gvnn3/sensor-fpga/docs/prompts.md

# Prompt Log — sensor-fpga

All user prompts given to the coding agent, recorded verbatim in reverse
chronological order (newest first). Each entry has the date and time
(HH:MM:SS) when the prompt was received.

---

## 28 Jul 2026 20:45:00

> Add the checklist to the bench sheet and reprint

---

## 28 Jul 2026 20:30:00

> I ordered the parts, add a bring-up checklist to the wiring doc

---

## 28 Jul 2026 20:15:00

> What is a good, small, speaker for the board? / Add the speaker to the
> parts sheet
> *(preceded by: Are these the Adafruit parts or? / Do I need cables for
> the I2C bus?)*

---

## 28 Jul 2026 19:55:00

> I will push, print the wiring diagram for the bench

---

## 28 Jul 2026 01:50:00

> Create a full walk through document explaining how the enire system works
> including the FPGA communication, RTOS, and how the FPGA DFX parts change
> at run time.

---

## 28 Jul 2026 01:40:00

> Create a wiring diagram for all sensors and add it to the docs directory.

---

## 28 Jul 2026 01:25:00

> Merge to main

---

## 28 Jul 2026 01:10:00

> Re-flash QSPI so standalone boot carries the dfx frames

---

## 28 Jul 2026 00:45:00

> Add telemetry information for the DFX switch.  Report on the DFX switched
> to and from the size of each DFX and how long the switch took.  All wokr
> in gnn-dfx-ctx branch.

---

## 28 Jul 2026 00:30:00

> Merge to main

---

## 28 Jul 2026 00:20:00

> I power cycled the board, verify the telemetry still flows

---

## 27 Jul 2026 23:59:00

> keep going until the flash boot passes the listener gate

---

## 27 Jul 2026 22:50:00

> Re-flash QSPI so standalone boot carries the new telemetry

---

## 27 Jul 2026 22:20:00

> Continue
> *(after interrupting a JTAG run/symbol-lookup tool call and switching model
> via /model; no correction given)*

---

## 27 Jul 2026 21:55:00

> keep going until the sensor telemetry shows up in the listener

---

## 27 Jul 2026 21:45:00

> keep going until the switch events show up in nc

---

## 27 Jul 2026 21:35:00

> Also add a telemtry packet whenever a switch is thrown, including the error
> state when multiple switches are thrown.  Indicate the switch number/name in
> the packet

---

## 27 Jul 2026 21:20:00

> Start a new branch gnn-tricorder-telemetry and use ultracode to add
> telemetry for all the sensors planned for the board.  When no data is
> present send a constant value that is outside the range of the sensor
> (-1, etc.)

---

## 27 Jul 2026 21:10:00

> Merge to main

---

## 27 Jul 2026 08:50:00

> There is an ethernet cable plugged in, this can be used for testing, it is
> on a DHCP capable network.  Keep going until the system gets an IP.  Add a
> switch to display the IP address on the 7 SEG display.  If no IP play the
> error sound and show "NO IP"

---

## 27 Jul 2026 08:30:00

> Create a new branch gnn-tricorder-ethernet and integrate an ethernet part
> into the system that can be used to get telemtry and other data our of the
> tricorder.  Use ultracode to create the spec and the code.

---

## 27 Jul 2026 08:10:00

> What kind of connectors do I need to buy to wire up the sensors?
> / Add the connector shopping list to the plan doc and the parts excel sheet

---

## 27 Jul 2026 07:50:00

> Update the plan doc and I will push everything

---

## 27 Jul 2026 07:40:00

> I moved JP1 to QSPI, power cycled, and it works

---

## 27 Jul 2026 07:28:20

> Boot from QSPI so the board runs standalone
> *(with "keep going until the standalone boot gate passes")*

---

## 27 Jul 2026 20:30:00

> Try the promiscuous mode fix and retest ping
> / keep going until it gets an IP

---

## 27 Jul 2026 08:50:00

> There is an ethernet cable plugged in, this can be used for testing, it is
> on a DHCP capable network.  Keep going until the system gets an IP.  Add a
> switch to display the IP address on the 7 SEG display.  If no IP play the
> error sound and show "NO IP"

---

## 27 Jul 2026 08:30:00

> Create a new branch gnn-tricorder-ethernet and integrate an ethernet part
> into the system that can be used to get telemtry and other data our of the
> tricorder.  Use ultracode to create the spec and the code.

---

## 27 Jul 2026 07:05:00

> Update the plan doc with the full session status

---

## 27 Jul 2026 06:56:01

> Add the boot chirp and switch functions to the notebook

---

## 27 Jul 2026 06:40:00

> The alert sound should also play when a DFX signature mismatch occurs

---

## 27 Jul 2026 06:20:00

> The scan sound should also play at boot

---

## 27 Jul 2026 00:10:00

> The DFX personalities should be tied to the functions of the switches.

---

## 26 Jul 2026 23:55:00

> I will push, flip the switches and test the sounds now

---

## 26 Jul 2026 21:25:00

> There is now a sounds directory.  Add the two mp3 files to the repo.  The
> scan sound should be triggered whenever a function is turned on by a
> switch.

---

## 26 Jul 2026 14:30:00

> There are 15 switches on the board and and 8 digit display.  Attach one
> function to each switch and when the function is triggered put a readout
> on the display.  For now there are no real devices, but this is a test
> mode to show that each function can be turned on or off.  Each function
> is exclusive, e.g. if more than one switch is in the ON position anerror
> should be shown on the display.  Design the system and use ultracode to
> implement it.  Create a new document manual.md that is the user manual
> and says what the switches control.

---

## 26 Jul 2026 13:50:00

> Try the ILA on the icap_axis stream
> *(ILA captured constant 0xCCCCCCCC with perfect quad timing — flash
> silent to the XIP core's quad command; XIP standard-mode chain launched)*

---

## 26 Jul 2026 11:30:00

> Try the XIP retry with the fixed STARTUPE2 path
> *(with "keep going until the swap time is measured" continuations)*

---

## 26 Jul 2026 10:20:00

> Try the quad mode SPI speedup

---

## 26 Jul 2026 00:30:00

> Try the QSPI slot table with the compressed partials

---

## 26 Jul 2026 00:05:00

> Try the bitstream compression on the partials

---

## 25 Jul 2026 17:00:00

> Try the AXIS-FIFO writer to get swaps under 20 ms
> *(and "keep going until the swap time is measured")*

---

## 25 Jul 2026 16:30:00

> Try the swap time optimization with taskENTER_CRITICAL

---

## 25 Jul 2026 15:21:12

> I will push, update the notebook with the demo entry first

---

## 25 Jul 2026 10:05:00

> Describe and document how to run the demo.  Commit that as a separate
> demo.md in the docs directory.

---

## 25 Jul 2026 09:50:00

> keep going / Continue
> *(several continuation prompts through the M4-M7 gate runs and the
> integrated demo: "keep going until all M gates pass", "Do not make me
> tell you to keep going, just go. Do not stpo until al M gates pass.",
> "keep going until done", "keep going", "Continue")*

---

## 25 Jul 2026 00:45:00

> Kill the3 sub shells, figure out why they were stuc, and then complete all
> of M4-M7.

---

## 25 Jul 2026 00:12:00

> Update the notebook as each milestone completes

---

## 25 Jul 2026 00:08:00

> When done write up the whole session in the plan doc

---

## 25 Jul 2026 00:05:00

> Do M4 through M7 as the builds finish

---

## 24 Jul 2026 23:52:00

> Do M7

---

## 24 Jul 2026 23:38:00

> Do M6

---

## 24 Jul 2026 23:12:00

> Do M5

---

## 24 Jul 2026 23:05:00

> Do M4

---

## 24 Jul 2026 22:56:30

> Do M3

---

## 24 Jul 2026 22:47:00

> Do M2

---

## 24 Jul 2026 22:42:00

> Do M1

---

## 24 Jul 2026 22:36:30

> Do you need me to run the udev installer yet?

---

## 24 Jul 2026 22:33:00

> Do M0, I'll run the udev installer when you need it

---

## 24 Jul 2026 22:10:00

> Read the docs directory, using ultracode plan the project and describe the
> plan here.  Work in a new branch gnn-a7-tricorder.  The target board is the
> NEXYS A7 and one is connected to this host.

---

## 5 Jul 2026 05:33:22

> This host has 2025.2

---

## 5 Jul 2026 05:14:19

> Continue

---

## 5 Jul 2026 05:08:00

> Write the master XDC for the full sensor complement.

---

## 5 Jul 2026 05:01:07

> Pick the exact A7 board, assume the Arty A7-100T.

---

## 5 Jul 2026 04:58:12

> FreeRTOS is fine fro this application.

---

## 5 Jul 2026 04:30:06

> If I want to run this on the A7 does that have any sort of CPU on which to
> run a typical program?

---

## 5 Jul 2026 04:19:27

> The spreadsheet is updated, re-read it.

---

## 5 Jul 2026 04:11:47

> Can the Tricorder be prototyped on this larger board without access to the
> A7?

---

## 5 Jul 2026 03:53:38

> Try again, I just copied it over.

---

## 5 Jul 2026 03:45:29

> The parts list is in docs now, go find it.

---

## 5 Jul 2026 03:41:44

> *(Pasted transcript of the claude.ai share link from the previous prompt —
> a separate Claude conversation titled roughly "FPGA as a sensor platform".
> Extracted content recorded in notebook entry 4. Transcript excerpts:)*
>
> Treat the FPGA as a sensor platform. What are good examples of data that
> needs low latency processing and to which an FPGA's customizable circuitry
> would be most useful.
>
> [Claude's answer: RF/SDR, network packet streams, machine vision,
> physics instrumentation, control loops]
>
> Are there already open source libraries of such circuits? Prioritize non
> network solutions for now. Physics and vision and real world sensors take
> priority.
>
> [Claude's answer: OHWR, hls4ml, FINN, Vitis Vision, PYNQ, Vitis DSP,
> LiteX/FuseSoC, ZipCPU cores]
>
> Provide a bibliography of papers that are published on these libraries or
> with them. Give links to papers and repositories in the vivl
>
> [Result: 14-entry BibTeX bibliography ("Fpga sensor libs" BIB artifact,
> not included in the paste); also a "Tricorder parts" XLSX with
> Adafruit-prioritized sensor parts list, not included in the paste]

---

## 5 Jul 2026 03:38:27

> Look at this link, can you extract the information from it
> https://claude.ai/share/3ff13c9b-f27d-47c6-ba76-99bd91a29c7b

---

## 5 Jul 2026 00:12:20

> Fix the commits with the rigth email.

---

## 5 Jul 2026 00:08:03

> I will push, you are NEVER to push

---

## 5 Jul 2026 00:07:26

> Add all files and commit

---

## 4 Jul 2026 07:34:03

> Study the open hardware site (ohwr.org) and find software moduels that
> coiuld run on the hardware in this host. The same requirements apply, the
> modules must be able to run in the dynamic region.

---

## 4 Jul 2026 07:26:08

> Look at the https://github.com/xilinx/vitis_libraries repo and explain
> wehther or not those libraries can be used in the dynamic region of the
> FPGA in this system.

---

## 4 Jul 2026 07:20:01

> This is a new repository for experiments having to do with creating dynamic
> sensor FGPA programs (each sensor type can be loaded or removed at runtime
> from the FGPA dynamic region). Create a docs directory with a notebook.md
> file useing the /notebook skill. Entries are kept in reverse chronological
> order and have both a date and a time (hours:min:sec) for when the entry was
> created. Also create a prompts.md in docs and record all prompts.
