gvnn3/sensor-fpga/docs/tricorder_parts.xlsx

Category | Supplier | Part | Qty | Unit Price (USD) | Line Total (USD) | Price Status | Purchase URL | Tricorder Function | Notes
Low-rate / quality | Adafruit | Adafruit BME688 #5046 (gas+temp+RH+pressure, I2C) | 1 | $31.11 |  | VERIFIED DigiKey Jul 2026 | https://www.adafruit.com/product/5046 | Atmospheric/air composition; environment | MOX gas = estimated VOC index, needs baseline cal
Low-rate / quality | Adafruit | Adafruit SCD-41 #5190 (true CO2, NDIR, I2C) | 1 | $49.50 |  | ESTIMATE - not captured this session | https://www.adafruit.com/product/5190 | Atmospheric composition (true CO2) | Only real CO2 ppm in this list
Low-rate / quality | Adafruit | Adafruit VEML7700 #4162 (16-bit lux, I2C) | 1 | $7.24 |  | VERIFIED DigiKey Jul 2026 | https://www.adafruit.com/product/4162 | Light scan (lux) | 0.005-120k lux
Low-rate / quality | Adafruit | Adafruit AS7341 #4698 (11-ch spectral, I2C) | 1 | $15.95 |  | ESTIMATE - not captured this session | https://www.adafruit.com/product/4698 | Composition analysis (crude spectroscopy) | 350-1000 nm
High-rate / DFX | Adafruit | Adafruit PDM MEMS mic #3492 | 6 | $4.95 |  | ESTIMATE - not captured this session | https://www.adafruit.com/product/3492 | Lifeform/motion detection (acoustic localization) | Beamforming array; onboard mic for bring-up first
Low-rate / optional | SparkFun | SparkFun MAX30105 particle/pulse-ox #14045 (I2C) | 1 | $19.50 |  | ESTIMATE - not captured this session | https://www.sparkfun.com/products/14045 | Medical variant (pulse/SpO2) | Adafruit has no stock MAX3010x; SparkFun is best-documented
High-rate / DFX | Generic (eBay/AliExpress) | AD9226 ADC module, 12-bit 65 MS/s parallel, Pmod form | 1 | $25.00 |  | ESTIMATE - generic ~$10-30 | https://fraserinnovations.com/product/fii-bd9226-high-speed-ad-module-12-digital-65mhz-data-sampling-ad9226/ | EM/RF environment scan; sonar RX; transient capture | No Adafruit equivalent. Shared wideband front end
High-rate / DFX | Generic (eBay/AliExpress) | AD9708 DAC module, 8-bit 125 MS/s (often AD9280+AD9708 combo) | 1 | $20.00 |  | ESTIMATE - ~$15-25 | https://www.ebay.com/sch/i.html?_nkw=AD9708+module | Active probing/stimulus (source, sweep, ultrasound TX) | No Adafruit equivalent
High-rate / DFX | Generic (eBay/Amazon) | OV7670 camera module (8-bit DVP, 640x480@30fps) | 1 | $8.00 |  | ESTIMATE - ~$5-12 | https://www.amazon.com/ov7670-camera-module/s?k=ov7670+camera+module | Lifeform/motion detection (vision) | Adafruit discontinued theirs. Get version WITHOUT FIFO
High-rate / DFX | onsemi (DigiKey/Mouser) | SiPM module (onsemi MICROFC-SMA-10035-GEVB eval) | 1 | $150.00 |  | ESTIMATE - unverified; hobby SiPM $30-60 AliExpress | https://www.digikey.com/en/products/detail/onsemi/MICROFC-SMA-10035-GEVB/6220699 | Photon detection / ranging (ToF, photon counting) | No Adafruit equivalent. Needs fast comparator e.g. TLV3501
High-rate / DFX | Generic (eBay/AliExpress) | AD8332 VGA board (ultrasound AFE) | 1 | $30.00 |  | ESTIMATE - ~$25-40 | https://www.ebay.com/sch/i.html?_nkw=AD8332+module | Sonar / structure probing (ultrasound AFE) | No Adafruit equivalent
High-rate / DFX | Generic (Amazon) | Piezo ultrasonic transducers, 40 kHz pair (TX/RX) | 2 | $3.00 |  | ESTIMATE | https://www.amazon.com/s?k=40khz+ultrasonic+transducer+piezo | Sonar / structure probing (pulse-echo TX/RX) | 1 MHz medical piezo is a later upgrade
Wiring / connectors | Generic (Amazon) | Dupont jumper wire kit, M-M + M-F + F-F, 10 cm + 20 cm | 1 | 12 |  | ESTIMATE | https://www.amazon.com/s?k=dupont+jumper+wire+kit | Harness for camera, ADC/DAC, mics, AFE control | Short (10 cm) runs for cam_pclk and adc bus
Wiring / connectors | Generic (Amazon) | 0.1 in male pin headers, 2x6 Pmod plugs (pack) | 1 | 8 |  | ESTIMATE | https://www.amazon.com/s?k=2x6+pin+header+2.54mm | Clean mating into JA/JB/JC/JD/JXADC sockets | Alternative: Digilent 2x6 Pmod cable kits
Wiring / connectors | Adafruit | STEMMA QT / Qwiic JST-SH 4-pin cable, 100 mm (#4210) | 4 | 0.95 |  | ESTIMATE | https://www.adafruit.com/product/4210 | I2C daisy chain across the 5 sensor breakouts | Breakouts carry onboard pull-ups; no resistors needed
Wiring / connectors | Adafruit | JST-SH 4-pin to male dupont adapter cable (#4209) | 1 | 0.95 |  | ESTIMATE | https://www.adafruit.com/product/4209 | Qwiic chain entry into Pmod JA1/JA2 | One per harness
Wiring / connectors | Generic (Amazon) | SMA male-male cable, RG316, ~30 cm | 1 | 8 |  | ESTIMATE | https://www.amazon.com/s?k=sma+male+to+male+rg316 | SiPM eval board to comparator input | SiPM board is SMA-only
Wiring / connectors | Generic (Amazon) | SMA female pigtail / edge adapter to 0.1 in | 2 | 4 |  | ESTIMATE | https://www.amazon.com/s?k=sma+female+pigtail+breadboard | SiPM comparator + AD8332 analog entries | One for TLV3501 input, one spare for AFE
Wiring / connectors | Generic (Amazon) | Solderless breadboard 830pt + wire kit | 1 | 10 |  | ESTIMATE | https://www.amazon.com/s?k=830+breadboard+kit | TLV3501 comparator, mic-array fan-out, AFE area | -
Wiring / connectors | Generic (Amazon) | Screw terminal block, 2-pin 0.1 in (pack) | 1 | 5 |  | ESTIMATE | https://www.amazon.com/s?k=screw+terminal+2.54mm | Piezo TX/RX bare-wire attachment | Twisted pair to the transducers
Wiring / connectors | Adafruit | Adafruit STEMMA Speaker #3885 (enclosed, class-D amp, JST-PH) | 1 | 5.95 |  | ESTIMATE | https://www.adafruit.com/product/3885 | Audible scan/alert sounds at the bench | Power from Pmod 3V3+GND; signal from the AUD 3.5 mm jack
Wiring / connectors | Generic (Amazon) | 3.5 mm mono plug to bare-wire pigtail | 1 | 4 |  | ESTIMATE | https://www.amazon.com/s?k=3.5mm+mono+plug+pigtail | Tap the Nexys AUD jack into the STEMMA speaker input | Mono jack: tip = signal, sleeve = GND
 |  | TOTAL
Adafruit parts shaded and sorted first (preferred supplier). Non-Adafruit parts have no Adafruit equivalent. Prices 2026-07-05: 'VERIFIED' seen in a distributor listing this session; 'ESTIMATE' from prior knowledge/typical range - confirm before ordering. Unit prices (blue) editable; totals are formulas.
