gvnn3/sensor-fpga/hw/constraints/switches-7seg.xdc

## ---------------------------------------------------------------------------
## Tricorder test-mode switch/7-seg constraints — Digilent Nexys A7-100T
## (xc7a100tcsg324-1)
##
## sw[15:0]  all 16 slide switches -> axi_gpio_3 (16-bit input, 0x40030000).
##           SW0..SW14 select the 15 test-mode functions; SW15 is reserved
##           (constrained here, ignored by software).
## seg[7:0]  cathode segments, ACTIVE-LOW at the pins; bit order fixed:
##           bit0=CA bit1=CB bit2=CC bit3=CD bit4=CE bit5=CF bit6=CG bit7=DP.
##           The top-level scanner RTL inverts from the active-high 64-bit
##           display register ({axi_gpio_4 ch2, ch1}) before driving these.
## an[7:0]   digit anodes, ACTIVE-LOW; an[0] = rightmost digit (AN0),
##           an[7] = leftmost (AN7) — matches display-register byte order.
##
## Pin LOCs and IOSTANDARDs copied verbatim from the Digilent
## Nexys-A7-100T master XDC. SW8 (T8) and SW9 (U8) sit in bank 34 and are
## LVCMOS18 per that file — preserved exactly; all other pins LVCMOS33.
## ---------------------------------------------------------------------------

## ---------------------------------------------------------------------------
## Switches (SW0..SW14 = function select, SW15 reserved)
## ---------------------------------------------------------------------------
set_property -dict { PACKAGE_PIN J15   IOSTANDARD LVCMOS33 } [get_ports { sw[0] }];  #IO_L24N_T3_RS0_15 Sch=sw[0]
set_property -dict { PACKAGE_PIN L16   IOSTANDARD LVCMOS33 } [get_ports { sw[1] }];  #IO_L3N_T0_DQS_EMCCLK_14 Sch=sw[1]
set_property -dict { PACKAGE_PIN M13   IOSTANDARD LVCMOS33 } [get_ports { sw[2] }];  #IO_L6N_T0_D08_VREF_14 Sch=sw[2]
set_property -dict { PACKAGE_PIN R15   IOSTANDARD LVCMOS33 } [get_ports { sw[3] }];  #IO_L13N_T2_MRCC_14 Sch=sw[3]
set_property -dict { PACKAGE_PIN R17   IOSTANDARD LVCMOS33 } [get_ports { sw[4] }];  #IO_L12N_T1_MRCC_14 Sch=sw[4]
set_property -dict { PACKAGE_PIN T18   IOSTANDARD LVCMOS33 } [get_ports { sw[5] }];  #IO_L7N_T1_D10_14 Sch=sw[5]
set_property -dict { PACKAGE_PIN U18   IOSTANDARD LVCMOS33 } [get_ports { sw[6] }];  #IO_L17N_T2_A13_D29_14 Sch=sw[6]
set_property -dict { PACKAGE_PIN R13   IOSTANDARD LVCMOS33 } [get_ports { sw[7] }];  #IO_L5N_T0_D07_14 Sch=sw[7]
set_property -dict { PACKAGE_PIN T8    IOSTANDARD LVCMOS18 } [get_ports { sw[8] }];  #IO_L24N_T3_34 Sch=sw[8] (bank 34, LVCMOS18 per Digilent master)
set_property -dict { PACKAGE_PIN U8    IOSTANDARD LVCMOS18 } [get_ports { sw[9] }];  #IO_25_34 Sch=sw[9] (bank 34, LVCMOS18 per Digilent master)
set_property -dict { PACKAGE_PIN R16   IOSTANDARD LVCMOS33 } [get_ports { sw[10] }]; #IO_L15P_T2_DQS_RDWR_B_14 Sch=sw[10]
set_property -dict { PACKAGE_PIN T13   IOSTANDARD LVCMOS33 } [get_ports { sw[11] }]; #IO_L23P_T3_A03_D19_14 Sch=sw[11]
set_property -dict { PACKAGE_PIN H6    IOSTANDARD LVCMOS33 } [get_ports { sw[12] }]; #IO_L24P_T3_35 Sch=sw[12]
set_property -dict { PACKAGE_PIN U12   IOSTANDARD LVCMOS33 } [get_ports { sw[13] }]; #IO_L20P_T3_A08_D24_14 Sch=sw[13]
set_property -dict { PACKAGE_PIN U11   IOSTANDARD LVCMOS33 } [get_ports { sw[14] }]; #IO_L19N_T3_A09_D25_VREF_14 Sch=sw[14]
set_property -dict { PACKAGE_PIN V10   IOSTANDARD LVCMOS33 } [get_ports { sw[15] }]; #IO_L21P_T3_DQS_14 Sch=sw[15] (reserved, ignored by software)

## ---------------------------------------------------------------------------
## 7-segment display — cathodes (active-low), bit0=CA .. bit6=CG, bit7=DP
## ---------------------------------------------------------------------------
set_property -dict { PACKAGE_PIN T10   IOSTANDARD LVCMOS33 } [get_ports { seg[0] }]; #IO_L24N_T3_A00_D16_14 Sch=ca
set_property -dict { PACKAGE_PIN R10   IOSTANDARD LVCMOS33 } [get_ports { seg[1] }]; #IO_25_14 Sch=cb
set_property -dict { PACKAGE_PIN K16   IOSTANDARD LVCMOS33 } [get_ports { seg[2] }]; #IO_25_15 Sch=cc
set_property -dict { PACKAGE_PIN K13   IOSTANDARD LVCMOS33 } [get_ports { seg[3] }]; #IO_L17P_T2_A26_15 Sch=cd
set_property -dict { PACKAGE_PIN P15   IOSTANDARD LVCMOS33 } [get_ports { seg[4] }]; #IO_L13P_T2_MRCC_14 Sch=ce
set_property -dict { PACKAGE_PIN T11   IOSTANDARD LVCMOS33 } [get_ports { seg[5] }]; #IO_L19P_T3_A10_D26_14 Sch=cf
set_property -dict { PACKAGE_PIN L18   IOSTANDARD LVCMOS33 } [get_ports { seg[6] }]; #IO_L4P_T0_D04_14 Sch=cg
set_property -dict { PACKAGE_PIN H15   IOSTANDARD LVCMOS33 } [get_ports { seg[7] }]; #IO_L19N_T3_A21_VREF_15 Sch=dp

## ---------------------------------------------------------------------------
## 7-segment display — digit anodes (active-low), an[0]=rightmost .. an[7]=leftmost
## ---------------------------------------------------------------------------
set_property -dict { PACKAGE_PIN J17   IOSTANDARD LVCMOS33 } [get_ports { an[0] }]; #IO_L23P_T3_FOE_B_15 Sch=an[0]
set_property -dict { PACKAGE_PIN J18   IOSTANDARD LVCMOS33 } [get_ports { an[1] }]; #IO_L23N_T3_FWE_B_15 Sch=an[1]
set_property -dict { PACKAGE_PIN T9    IOSTANDARD LVCMOS33 } [get_ports { an[2] }]; #IO_L24P_T3_A01_D17_14 Sch=an[2]
set_property -dict { PACKAGE_PIN J14   IOSTANDARD LVCMOS33 } [get_ports { an[3] }]; #IO_L19P_T3_A22_15 Sch=an[3]
set_property -dict { PACKAGE_PIN P14   IOSTANDARD LVCMOS33 } [get_ports { an[4] }]; #IO_L8N_T1_D12_14 Sch=an[4]
set_property -dict { PACKAGE_PIN T14   IOSTANDARD LVCMOS33 } [get_ports { an[5] }]; #IO_L14P_T2_SRCC_14 Sch=an[5]
set_property -dict { PACKAGE_PIN K2    IOSTANDARD LVCMOS33 } [get_ports { an[6] }]; #IO_L23P_T3_35 Sch=an[6]
set_property -dict { PACKAGE_PIN U13   IOSTANDARD LVCMOS33 } [get_ports { an[7] }]; #IO_L23N_T3_A02_D18_14 Sch=an[7]

# Mono audio out (PWM through the on-board 4th-order LPF) + amp enable
set_property -dict { PACKAGE_PIN A11 IOSTANDARD LVCMOS33 } [get_ports aud_pwm]; #IO_L4N_T0_15 Sch=aud_pwm
set_property -dict { PACKAGE_PIN D12 IOSTANDARD LVCMOS33 } [get_ports aud_sd];  #IO_L6P_T0_15 Sch=aud_sd
