gvnn3/sensor-fpga/sw/tricorder-rtos/src/ui.h

/*
 * Tricorder test-mode UI: switch-selected 7-seg readouts.
 *
 * Other tasks publish live values through ui_live; ui_task samples the
 * switches every 100 ms and drives the 8-digit display registers.
 */

#ifndef UI_H
#define UI_H

/* Live values filled in by main.c's tasks (single-writer per field;
 * plain volatile is enough for these monotonic/latest-value readouts). */
struct ui_live {
    volatile int req_rm;        /* -1 none, 0 PDM, 1 sonar, 2 B, 3 A */
    volatile unsigned int ip;   /* DHCP lease, host byte order; 0 = none */
    /* Switch-change events: ui_task increments evt_seq after filling the
     * record; net_task emits one UDP event frame per new seq (it owns the
     * MAC). evt_sw: 0..15 selected, -1 none/idle, -2 multi-switch error. */
    volatile unsigned int evt_seq;
    volatile int evt_sw;
    volatile unsigned int evt_mask;   /* raw switch bits at the event */
    volatile int cur_rm;        /* loaded personality, -1 while swapping */
    /* DFX swap events: dfx_task fills the record then increments dfx_seq;
     * net_task emits one type=dfx UDP frame per new seq (same single-
     * writer pattern as evt_*). Ids use the req_rm encoding above. */
    volatile unsigned int dfx_seq;
    volatile int dfx_from;            /* RM loaded before the swap        */
    volatile int dfx_to;              /* RM requested                     */
    volatile unsigned int dfx_from_len;  /* partial sizes, bytes; 0 = n/a */
    volatile unsigned int dfx_to_len;
    volatile unsigned int dfx_us;     /* decouple->sig ICAP stream time   */
    volatile unsigned int dfx_flash_us; /* QSPI slot read time; 0 = DDR src */
    volatile int dfx_ok;              /* 1 signature matched, 0 mismatch  */
    volatile int      temp_centi;   /* ADT7420, centi-C (S4) */
    volatile unsigned swaps;        /* completed DFX swaps (S7) */
    volatile unsigned last_swap_us; /* last swap duration, us; 0 = none (S13) */
    volatile int      i2c_devices;  /* external bus scan result (S5) */
    volatile int      pcm;          /* last PDM PCM sample (S10, future) */
    volatile unsigned energy;       /* last PDM energy window (S11, future) */
    volatile unsigned peak;         /* last sonar peak (S12, future) */
};

extern struct ui_live ui_live;

void ui_task(void *arg);

/* Tag for switch id 0..15 ("PdM", "Snr", ...); "none"/"error" for -1/-2 */
const char *ui_fn_name(int id);
const char *ui_rm_name(int id);   /* req_rm encoding; -1 -> "NONE" */

#endif /* UI_H */
