gvnn3/sensor-fpga/(commit log)

2026-07-05 A list of parts for a tricorder projects with the Xilinx A7
    [tricorder_parts.xlsx]
2026-07-05 Record shared-conversation extraction: FPGA as a sensor platform
    Notebook entry 4 captures the pasted claude.ai share-link transcript:
    low-latency sensor workload classes, open-source library survey (OHWR,
    hls4ml, FINN, Vitis Vision/DSP, LiteX, ZipCPU), and pointers to the
    bibliography and tricorder-parts artifacts not included in the paste.
2026-07-05 Updated with the columns fixed.
    [tricorder_parts.xlsx]
2026-07-05 Notebook entry 5: tricorder parts list analysis (Artix-7 target)
    Parse tricorder_parts.xlsx and record the 13-part, $392 BOM; map
    low-rate I2C sensors to the static region and the seven high-rate
    front ends to per-sensor DFX modules.
2026-07-05 Notebook entry 8: board decision Arty A7-100T with pin/resource budget
2026-07-05 Add master XDC for full tricorder sensor complement on Arty A7-100T
    75 conflict-free pin assignments, LOCs verified against Digilent's
    Arty-A7-100-Master.xdc. OV7670 on high-speed JB/JC with PCLK clock
    constraints, AD9226 on the resistor-free ChipKit header, PDM array on
    JA, AD9708 on JD, SiPM/AFE/piezo on ChipKit inner pins. Notebook
    entry 9 records the allocation.
2026-07-05 Revise entry 10: Vivado 2023.1 (Artix-7 + free DFX) validates XDC clean
    /usr/local/cad has 2020.2/2023.1/2025.2; 2025.2 lacks Artix-7 device
    support, so 2023.1 is the working toolchain. Validation passes there:
    75/75 ports, 0 errors, 0 critical warnings.
2026-07-25 Plan Nexys A7-100T retarget: pin map, architecture, roadmap
    Board changes from Arty A7-100T to Nexys A7-100T (same XC7A100T-CSG324
    part, one attached to this host). Multi-agent planning run reconciled
    into docs/plan.md: 40/40 header-pin allocation keeping all sensing
    modalities wired (AD9708 DAC time-shares the AD9226 pins via IOBUFs),
    cam_pclk on the board's only P-side clock-capable header pin (JB10/H16),
    AD9226 derated to <=40 MS/s behind 200-ohm series resistors, MicroBlaze-V
    + FreeRTOS static region with DDR2 MIG and RMII shim on Vivado 2025.2,
    2-clock-region DFX partition, M0-M7 roadmap. Notebook entry 11 records
    the planning experiment; prompt logged.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
2026-07-25 M0 bring-up: blinky builds, programs, and runs on the Nexys A7-100T
    Vivado 2025.2 non-project flow: 0 warnings, WNS +7.2 ns, 3.83 MB
    bitstream programmed over JTAG (DONE=1, XADC die temp 48.6 C). No udev
    installer needed - plugdev group covers the FT2232. DFX confirmed
    license-free in 2025.2 via HD.RECONFIGURABLE probe, unblocking M5.
    Adds reusable program.tcl JTAG helper and notebook entry 12.
    Claude-Session: https://claude.ai/code/session_01JFCZE5zCJbM3sB1FtBfeBa
2026-07-25 M1: Nexys A7 master XDC validates clean alongside Arty control
    New tricorder_top_nexys stub (58 ports) and
    tricorder-nexys-a7-100t.xdc implementing the plan section-2 allocation:
    40/40 header pins, ADC/DAC bus shared through IOBUFs, cam_pclk on
    H16 (the board's only P-side MRCC header pin), all LOCs verified
    against the current Digilent master XDC. validate_xdc.tcl rewritten as
    a parameterized CI gate (-tclargs <board>) with nonzero exit on
    unplaced ports, DRC errors, or critical warnings. Both boards PASS
    under Vivado 2025.2: nexys-a7 58/58, arty-a7 75/75, 0 DRC, 0 critical
    warnings. Notebook entry 13.
    Claude-Session: https://claude.ai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
2026-07-25 M2: MicroBlaze static region prints hello over UART
    Tcl-scripted block design (classic MicroBlaze, 32 KB LMB, UARTlite,
    GPIO LEDs) builds board-file-free in Vivado 2025.2 with WNS +2.7 ns.
    Bare-metal 250-byte ELF (own crt, polled UARTlite at pinned address
    0x40600000) loaded via xsdb prints "hello tricorder" on /dev/ttyUSB1.
    CPU decision ratified: classic MicroBlaze. 2025.2 ships the
    MicroBlaze-V IP but no FreeRTOS port for it (BSPs cover ARM +
    MicroBlazeV9 only), so the FreeRTOS requirement forces classic.
    Notebook entry 14.
    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
2026-07-25 M3: DDR2 calibrates and passes full 128 MiB memtest, 3/3 cycles
    MIG 7-series configured from Digilent's board-file mig.prj (committed;
    BD variant swaps SystemClock to No Buffer so clk_wiz feeds 100 MHz
    sys + 200 MHz ref). Build WNS +1.3 ns; automation added the AXI clock
    converter and 81.25 MHz ui_clk reset domain. Bare-metal memtest gates
    on init_calib_complete via GPIO ch2, then walks all of 0x80000000 +
    128 MiB: addr-in-addr, inverted, walking ones - 0 errors across three
    configuration cycles. Notebook entry 15.
    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
2026-07-25 M4: FreeRTOS boots on MicroBlaze; I2C proven via on-board ADT7420
    BD grows M4 peripherals (axi_intc wired to the CPU interrupt, axi_timer
    tick, axi_iic x2) plus the M5 DFX statics (HWICAP with eos_in tied
    high, DFX decoupler in MODE slave, RM AXI-Lite port at 0x44A10000,
    decouple GPIO). Two hardware lessons fixed en route: cache "None"
    leaves MicroBlaze with no instruction path to DDR (PC froze at
    0x80000000 - now 16KB I/D caches with MIG behind the cached port), and
    the FreeRTOS linker script must keep .vectors.* in LMB while the rest
    moves to DDR2.
    Vitis 2025.2 SDT flow scripted in sw/scripts/build_rtos.py. On the
    board: scheduler ticks steadily for 60 s, heartbeat + sensor tasks
    interlea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
2026-07-25 M5-M7: runtime DFX swaps at 390 ms; PDM and sonar RMs live on hardware
    M5: four-personality DFX flow (pr_verify clean), 1.07 MB partials,
    MicroBlaze-driven runtime swaps with signatures verified and the static
    region uninterrupted. AXI HWICAP v3.0 proved non-functional (write FSM
    wedges on the first chunk regardless of eos_in, clocking, JTAG state,
    or data); replaced with a raw ICAPE2 writer on the second ICAP site -
    GPIO-paced, UG470 bit-reversal in RTL - measuring 390,191 us per swap,
    inside the plan's PIO estimate. eos_in tie-high, explicit pblock site
    ranges (CLOCKREGION+SNAPPING snapped to empty), black-box stub, and
    bin_file partial format were all necessary fixes discovered en route.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
2026-07-25 Integrated demo: FreeRTOS rotates all four DFX personalities live
    New dfx_task in the FreeRTOS app swaps PDM -> SONAR -> B -> A every 8 s
    through the raw ICAPE2 writer, verifies signatures, and reads each
    personality's data registers - while the ADT7420 sampling and heartbeat
    tasks run uninterrupted through every swap. One-command demo via
    hw/scripts/run_rtos_dfx.xsdb. Swap under the RTOS measures 16.2 s
    (scheduler overhead on the GPIO pacing loop; bare-metal is 390 ms) -
    queued for a critical-section or FIFO-writer fix.
    Also: hw/Makefile CI targets (validate / ooc-rm / static / dfx / rtos)
    with hw/scripts/ooc_rm.tcl enforcing per-RM utilization budgets, and a
    cached full-range memtest re-r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
2026-07-25 Cut RTOS swap time 15.9 s -> 1.65 s; culprit was -O0, not preemption
    taskENTER_CRITICAL around the ICAP stream changed nothing - but the
    byte-identical per-swap timings it produced proved preemption was
    innocent. The Vitis app template builds at -O0; forcing O2 on dfx_task
    (plus inline bswap) gives 1.65 s per swap, 9.6x faster. Timing now uses
    the axi_timer's second counter since ticks freeze inside the critical
    section. Residual 4x vs bare-metal is cold-cache DDR reads + shared
    instruction fetch; next step change is the planned AXIS-FIFO writer.
    Notebook entry 22; demo.md figures updated.
    Claude-Session: https://claude.ai/code/session_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
2026-07-25 DMA-fed ICAPE2: swaps hit wire speed at 2.7 ms
    axi_dma (simple MM2S, 26-bit length) streams the staged partial from
    DDR2 straight into an AXIS sink on the ICAPE2 - one config word per
    100 MHz cycle, CSIB gated by tvalid, full 32-bit bit-reversal done in
    wiring (byteswap composed with UG470 per-byte reverse), so raw
    -bin_file bytes need no software preprocessing. Both loaders now
    program three DMA registers and poll Idle; the RTOS path drops its
    critical section entirely.
    Measured: bare-metal 2679 us per 1.07 MB swap - exactly the
    267,763-word/100 MHz theoretical, i.e. the configuration port's
    physical limit; FreeRTOS 2688 us with ticks and sensor tasks running
    through the swap. Swap-time hi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
2026-07-26 Compressed partials: sub-millisecond swaps
    BITSTREAM.GENERAL.COMPRESS on all DFX bitstreams: partials shrink
    2.5-3.4x (312-422 KB, content-dependent), the full image halves to
    1.9 MB, and pr_verify stays clean. MFWR frames stream through the
    DMA->ICAPE2 path at full rate: bare-metal swaps 781-1055 us (still
    exactly words/100MHz), FreeRTOS 903-1067 us with all signatures,
    PDM audio, and sonar bursts verified. Swap history closes at
    16.2 s -> 1.65 s -> 2.7 ms -> ~0.9 ms: a personality change now costs
    less than one scheduler tick. Notebook entry 24; demo.md updated.
    Claude-Session: https://claude.ai/code/session_01JFCZE5zCJbM3sB1FtBfeBa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
2026-07-26 QSPI slot table: personalities load from flash, no JTAG staging
    Partials live in the 16 MiB S25FL128S in 1 MiB slots; one script
    (build_flash.tcl) emits both the MCS image and the compiled-in slot
    manifest slots.h, and program_flash.tcl burns it over JTAG. Hardware:
    axi_quad_spi in command mode with per-signal BD ports - the top
    wrapper owns the IOBUFs and a STARTUPE2 driving the dedicated CCLK.
    Per swap the RTOS fast-reads the slot into a DDR2 bounce buffer and
    reuses the DMA->ICAPE2 wire-speed path, with signature-checked
    fallback to DDR staging.
    Final gate: JEDEC 01 20 18 at boot, all four personalities load from
    FLASH with signatures verified (PDM live audio, sonar bursts intact).
    ICAP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
2026-07-26 Quad SPI lands functionally; proves the flash reader is CPU-bound
    Core to quad mode at SCK/2 (50 MHz, 4 lanes ~ 25 MB/s wire), dq2/dq3
    wired through BD/top/XDC, S25FL128S QE bit set once at boot (WREN+WRR,
    verified by RDCR; persists). Quad 0x6B framing measured on hardware:
    RX overhead is 8 bytes (cmd + 3 addr + 8 dummy cycles at quad = 4
    bytes), not the naive 5 - the +3 data shift was caught by the per-RM
    signature check. All four personalities load from FLASH with correct
    data.
    Timing verdict: 4.9-6.1 s per slot, essentially unchanged - a 32x
    wire speedup moved totals <10%, so the polled driver (per-byte
    DTR/DRR AXI accesses) was always the bottleneck, wire never was.
    Identified root caus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
2026-07-26 XIP retry: 21 MB/s transfers proven, data framing unresolved; reverted
    On the fixed STARTUPE2/CCLK path, XIP-mode DMA transfers now complete:
    20.9 ms for a 444 KB slot (21.2 MB/s) - confirming entry 26's dead-CCLK
    root-cause theory for the original XIP failure. But the ICAP never
    synced in either flash byte order, implying an intra-word framing shift
    inside the XIP core's quad command sequence (Spansion 0xEB mode-bit /
    dummy-cycle handling) that software cannot observe or fix - XIPSR
    reports no errors and only the per-RM signature check catches it.
    Reverted to the entry-26 quad-command configuration (re-gated: all
    four personalities from FLASH, 4.9-6.1 s reads, sigs OK). The 20.9 ms
    figure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
2026-07-27 Test-mode UI: 15 switch functions, 7-seg readouts, tricorder sounds
    SW0-SW14 select 15 mutually exclusive test-mode functions; the 8-digit
    7-seg display shows each function's readout (live values for
    temperature, I2C device count, DFX swap count/time, uptime;
    placeholder On markers elsewhere), an idle trICordr banner, and
    Err SEL when more than one switch is up. The TOS tricorder scan sound
    plays whenever a function is switched on and the alert sound on
    entering the error state, from a 48 KiB BRAM audio ROM (sounds/*.mp3
    committed; tools/mp3_to_mem.py regenerates via miniaudio) through a
    sigma-delta PWM into the on-board audio filter.
    Hardware: axi_gpio_3/4/5 (switches, 64-bit segment regis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
2026-07-27 Switches drive the DFX personalities
    SW0-SW3 now load their personality for real: the ui task publishes the
    request (HELA maps to hello-A, HELB to hello-B), and dfx_task -
    rotation removed - swaps reactively, marking cur_rm during the load.
    The S0-S3 readouts track the state (---- while swapping, run when
    live), PCM/energy go live off the RM registers when PDM is loaded,
    sonar peak when sonar is loaded, and the sonar personality auto-fires
    a ranging burst every second while selected. The scan sound is now
    literally the personality load sound. Manual and demo updated.
    On-board gate: boot with no auto-rotation, idle banner byte-exact,
    sensors streaming; switch-flip loads verified by hand at t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
2026-07-27 Play the scan sound at boot
    main() pulses the scan trigger right after the boot banner; ui_task
    seeds its toggle state from the register so the first switch flip
    still edges. Register gate: AUDIO reads 1 after boot with the banner
    intact. Manual notes the power-on chirp.
    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
2026-07-27 Notebook entry 30: switch-driven personalities, boot chirp, mismatch alert
    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
2026-07-27 Plan doc: continuation status through entry 30
    Appends the post-milestone status to plan section 5: the swap-time
    arc (16.2 s to 0.8 ms), flash-resident personalities with the
    CPU-bound verdict, the closed XIP investigation with its ILA method,
    the test-mode UI with switch-driven personality loads and sounds, and
    the standing next steps.
    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
2026-07-27 Standalone QSPI boot: bitstream + bootloader + app, no host required
    The flash now carries the complete instrument: full_a.bit at 0x0
    (write_cfgmem -loadbit, SPI_BUSWIDTH 4, CONFIGRATE 33) with a 1.4 KB
    bootloader baked into the LMB BRAM via updatemem, the app as a
    scatter-load image at 0xD00000 (tools/mkbootimg.py packs the ELF's
    PT_LOAD segments), and the personality slots. The bootloader waits for
    DDR2 calibration, quad-reads the image, loads each segment - the
    app's vectors overwrite its own by design - and jumps.
    Two MCS images because write_cfgmem flags are global and config data
    vs slot data need opposite bit-order treatment; program_flash.tcl
    burns both ranges. Gate passed twice con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
2026-07-27 Entry 31 revision: power-on standalone boot confirmed on hardware
    George moved JP1 to QSPI and power cycled - the board boots the full
    tricorder from flash with no host attached.
    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
2026-07-27 Connector shopping list: plan section 6 + parts sheet rows
    Eight "Wiring / connectors" rows appended to tricorder_parts.xlsx
    (~$56 estimated: dupont kits, 2x6 Pmod plugs, Qwiic daisy cables +
    dupont adapter for the I2C chain, SMA cable + pigtails for SiPM/AFE,
    breadboard, screw terminals) with line-total formulas and the grand
    TOTAL extended to the new range. Plan gains a matching section with
    the wiring rationale: 10 cm runs for cam_pclk and the ADC bus, no
    harness pull-ups needed (breakouts carry them), SCD-41 current spikes
    on their own Pmod rail.
    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
2026-07-28 Ethernet: telemetry streams to the network; DHCP lease still pending
    Ultracode workflow produced docs/ethernet-spec.md (854 lines, all
    interfaces frozen), hw/rtl/rmii_shim.v, hw/constraints/ethernet.xdc and
    sw/tricorder-rtos/src/net.{c,h} (EmacLite driver, ARP, ICMP, UDP
    telemetry, no lwIP); its verifier caught the two integration gaps and a
    missing create_generated_clock. Integrated: axi_ethernetlite at
    0x40E00000, PHY-reset GPIO, 50 MHz clk_wiz output, shim + REFCLK ODDR in
    the top wrapper, net_task in main.c, plus a DHCP client and SW15 (IP on
    the 7-seg, "nO IP" + alert sound when leaseless).
    Hardware result: telemetry captured on this host with nc -ulp 5001
    (seq/uptime/temp_cc/rm...), P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
2026-07-28 DHCP lease acquired: 192.168.1.126, ping and telemetry both live
    Two stacked bugs, each masking the other. First, the bitstream still
    carried TX_LOOPBACK=1 from an earlier bisect, so the board was deaf to
    the wire during every receive measurement in entry 32 - removing it
    made real LAN traffic appear at once and disproved the MAC-filter
    theory. Second, and the actual defect: the RMII TX flops launch on the
    clk50 rising edge while the ODDR forwarded REFCLK rising at the same
    instant, so the PHY sampled TXD exactly as it changed. Zero setup
    margin, working or failing on placement luck - it worked on one build
    and died on the next. Forwarding REFCLK inverted (D1=0/D2=1) centres
    the PHY's sampli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
2026-07-28 Switch-event telemetry frames, verified on the wire
    Every switch transition now emits a UDP event frame within ~10 ms:
    type=event, evt sequence, sw number (-1 idle, -2 multi-switch error),
    the function name from the UI table, state, raw switch mask, uptime.
    ui_task publishes the record (it already owns transition detection for
    the sounds); net_task emits (single-writer rule for the MAC). Periodic
    frames gain type=telemetry so one listener distinguishes both.
    Wire-verified from the board's DHCP address via JTAG-injected records:
    active and error events captured interleaved with telemetry. Physical
    flips write the identical record. Noted: nc -ulp is single-datagram on
    this host - use a loop o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
2026-07-28 Full 75-key sensor telemetry live on the wire; two AXI IIC driver bugs fixed
    New sensors.c discovery/poll layer and net_telemetry.c emitter (frozen
    75-key schema, docs/telemetry-spec.md) replace the old 10-key frame and
    the unbounded I2C walk in main.c. All nine ultracode verifier findings
    (F1-F9) addressed: single emitter in net_telemetry.c, tri-state link
    detection, no fabricated in-range values from identity-only devices,
    below-floor readings emit error sentinels instead of clamping into
    range, RM-internal counters capability-gated, bounded I2C spins, NAK TX
    FIFO flush, doc example frames match as-built truth.
    Hardware bring-up found two PG090 driver bugs masking the whole bus:
    - IISR is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
2026-07-28 QSPI re-flash carries new telemetry; flash boot passes the listener gate
    Full DFX rebuild was required: the flashed full_a.bit predated the
    REFCLK ODDR inversion fix, so the standalone app booted but its
    Ethernet TX was dead on the wire (PHY loopback 0/60; DHCP discover
    unanswered) - a clean A/B confirmation of entry 33's phase diagnosis,
    since only the bitstream differed between the failing and passing runs.
    The rebuild surfaced and removed the inert ethernet ILA block in
    build_dfx.tcl (create_debug_core "vacant channels" bug, never worked);
    its removal shrank every RM partial ~15%, which changed the generated
    slots.h and forced the documented rebuild order: DFX build -> app
    rebuild (slot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
2026-07-28 Cold power-cycle confirmed: standalone flash boot streams telemetry
    User power-cycled the board (JP1 on QSPI): FPGA configured from flash,
    bootloader pulled the app from flash, DHCP lease reacquired, and the
    listener captured 16 full 75-key frames in 20 s with live ADT7420
    readings (temp_cc=3306). QE bit survived the power cycle as expected
    (non-volatile). Entry 35 observation added; open item removed.
    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
2026-07-28 DFX swap telemetry: from/to personality, partial sizes, swap time
    Each attempted personality swap now emits an aperiodic type=dfx UDP
    frame: RM id and name switched from and to, byte size of each partial
    bitstream (from the source actually streamed), decouple-to-signature
    swap time in microseconds, signature verdict, lifetime swap counter.
    dfx_task publishes the record and bumps ui_live.dfx_seq; net_task
    emits - same single-writer pattern as the switch events. Failed swaps
    are reported with sig=mismatch rather than suppressed.
    The common UDP broadcast tail moved from net_send_event into
    udp_bcast_finish(), shared by event and dfx frames. Also fixed two F5
    stragglers the earlier pass missed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
2026-07-28 QSPI re-flash: standalone boot emits dfx swap frames
    Bootimg repack only - bitstream and partials unchanged, slots.h stable.
    QE restored after programming (entry 35 procedure). Flash-booted board
    reacquired its lease and the listener captured type=dfx frames
    (A->PDM, swap_us=1039, sizes matching the slot manifest) alongside the
    1 Hz telemetry. Entry 36 updated with the standalone confirmation.
    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
2026-07-28 Wiring diagram for the full sensor complement
    docs/wiring.md: system overview and I2C daisy-chain as mermaid
    diagrams, pin-exact per-Pmod tables from the master XDC (JA control
    lane, JB/JC camera, JC/JD ADC/DAC bus, JXADC mic array), sonar/AFE
    chain, on-board sensor summary, and the power constraints (SCD-41
    peak current isolation, ADC derating, coupled-pair crosstalk note).
    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
2026-07-28 System walkthrough: architecture, boot, RTOS, comms, run-time DFX
    docs/walkthrough.md: end-to-end explanation of the instrument - static
    region SoC and address map with the experiment-backed design decisions,
    QSPI boot chain and flash layout, FreeRTOS task structure and the
    single-writer blackboard pattern, communication paths (UART, raw-frame
    Ethernet stack, three telemetry frame types), and the full DFX story:
    floorplan/boundary, the DMA->ICAPE2 load path with sequence diagram,
    why HWICAP was abandoned, bit-encoding quirks, signature trust chain,
    and personality/capability gating. Cross-referenced to notebook entries
    throughout.
    Claud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
2026-07-28 Bench-printable wiring sheet (2-page PDF)
    docs/wiring-bench.pdf: condensed print version of wiring.md - all four
    Pmod pin tables, sonar chain, on-board summary, and the power warnings,
    sized for two Letter pages. Generated with fpdf2 (generator script kept
    in the session scratchpad); sent to the bench printer.
    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
2026-07-29 Parts sheet: STEMMA speaker + audio jack pigtail
    Rows 22-23: Adafruit STEMMA Speaker #3885 (enclosed class-D amp,
    powered from Pmod 3V3, signal from the AUD 3.5 mm jack) and a mono
    3.5 mm plug-to-bare-wire pigtail to tap the jack. TOTAL formula
    extended to F2:F23.
    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
2026-07-29 Wiring doc: incremental bring-up checklist
    Section 9: ordered bring-up for the arriving parts - polarity checks,
    speaker first (instant feedback), I2C chain one device at a time with
    the exact UART/telemetry observable for each (including the identity-
    only devices whose ERROR state still proves wiring), mic array, camera
    SCCB-first, ADC/DAC, sonar chain last, and a post-session regression
    check. Leans on automatic discovery: no rebuilds for any I2C step.
    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
2026-07-29 Bench sheet: bring-up checklist page, reprinted
    Page 3 of docs/wiring-bench.pdf: the section-9 checklist as printable
    checkboxes - polarity checks, speaker, one-at-a-time I2C chain with
    per-device pass signals, mic array, camera, ADC/DAC, sonar chain,
    post-session regression. Sent to the bench printer.
    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
2026-08-07 feat(rtos): report QSPI read time in dfx frame
    t_spi was measured but only printed to UART. Telemetry now separates
    the two swap costs: swap_us (ICAP stream, ~1 ms) vs new flash_us
    (QSPI slot read, seconds, CPU-bound); flash_us=0 means DDR staging.
    Spec 1.8 frame grows to 13 lines.
    Also drop the duplicated axi_quad_spi register defines in main.c.
2026-08-07 feat(tricorder_ui): always-on rotating frame log
    Raw frames (telemetry, event, dfx) land in
    tricorder-logs/telemetry.log: 1 MiB per file, 32 files kept
    (~8 h at 1 Hz). --log-dir moves it, --no-log disables.
2026-08-08 feat(tricorder_ui): show flash_us in footer
    Last-known QSPI staging time from the type=dfx frame, rendered as
    FLASH:N.NNs next to SWAPS. Aperiodic event/dfx frames no longer
    displace the telemetry snapshot - each swap used to blank the whole
    display for a second.
2026-08-08 perf(rtos): enable I/D caches - flash staging 5.9s -> 0.28s
    16 KB caches existed in hardware since M3 but nothing ever enabled
    them; every instruction fetch was a MIG round trip (~400 cyc/op,
    measured). Two lines in main() give 21x on the QSPI slot read and
    ~14x on all MMIO. D-cache is write-through so the ICAP DMA path
    stays coherent. Personality swap on a switch throw is now ~0.28 s
    end to end. Notebook entry 38 has the full profile.
2026-08-08 docs(notebook): entry 39 - 1 hr cache-enable soak PASS
    3579/3579 telemetry frames (zero UDP loss), 44/44 swap signatures OK
    across 11 full rotations, no reboots, temp flat, i2c clean. Entry 38's
    DMA-coherence risk retired for all currently exercised paths; S2MM
    streaming remains the one untested direction.
2026-10-30 feat(skills): add run-sensor-fpga driver + skill
    Agent harness for the tricorder demo: driver.py boots the board via
    xsdb, captures the UART console, grabs a telemetry frame, launches the
    Tk GUI, feeds it canned frames headless, and screenshots the window
    (xwd -id + manual XWD parse; no screenshot tool on the box and root
    grabs fail under XWayland). SKILL.md documents the verified path and
    the gotchas hit while building it.
2026-10-30 docs(demo): staging takes ~12 s, not minutes
    Measured twice on 2026-10-29: run_rtos_dfx.xsdb completes in 12 s
    including the four partial downloads. Drop the "couple of minutes"
    warning and tie the troubleshooting row to the script's final
    "RTOS_DFX: running" line instead of "staging is slow".
2026-10-30 docs(notebook): entry 40 - agent run skill and driver
2026-10-30 feat(skills): driver swap/rotate - xsdb-driven DFX personality swaps
    Poke ui_live.req_rm (address resolved from the ELF via nm each run,
    it moves between builds) with stop/mwr/con in one xsdb session, collect
    the type=dfx UDP frames on a listener thread, and assert sig=ok and the
    requested target per hop. rotate does pdm->sonar->b->a and prints
    swap_us/flash_us per hop; both exit 1 on a missing frame, bad
    signature, or MISMATCH/DMA error in the console log. Measured on the
    board: 775-1028 us swaps, 210-278 ms flash reads, 8.8 s for 3 hops.
